poojamaurya22/uo/docs/walle_head_tilt.png

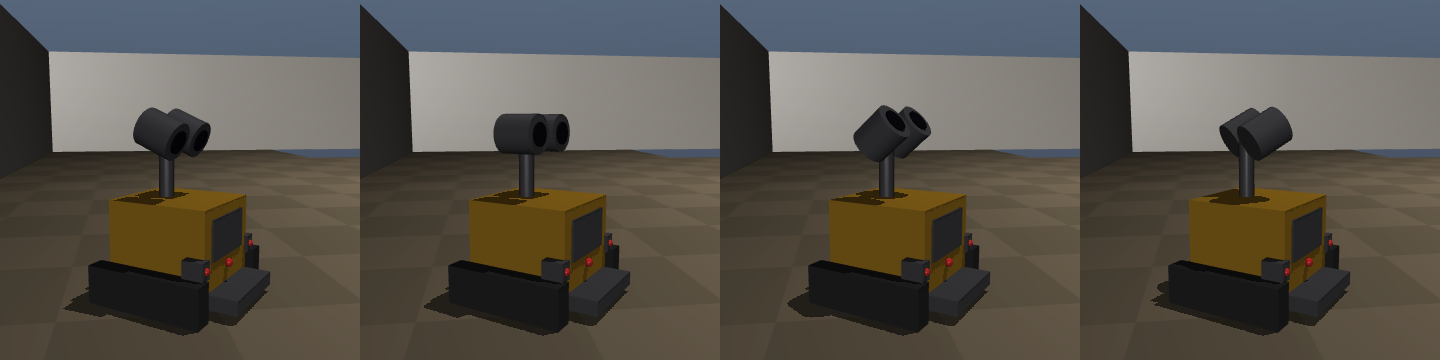
docs/walle_head_tilt.png
