poojamaurya22/uo/docs/walle_photo.png

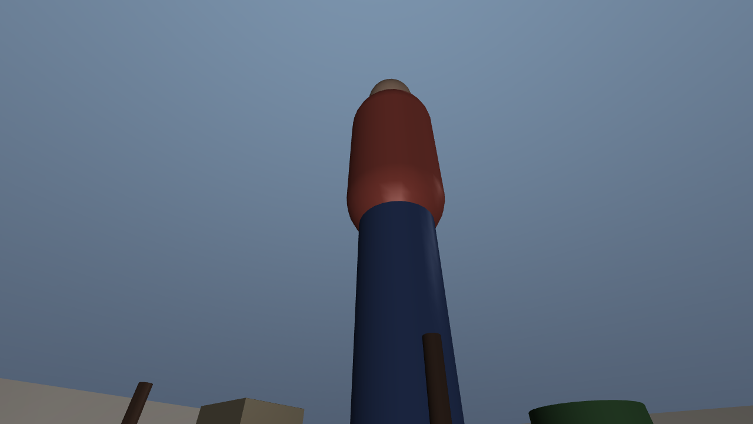
docs/walle_photo.png
