poojamaurya22/uo/hardware/preview/belt.png

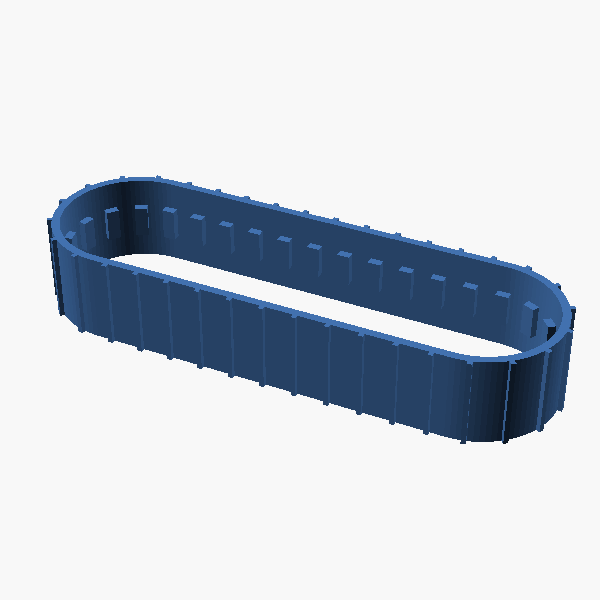
hardware/preview/belt.png
