poojamaurya22/uo/hardware/preview/body.png

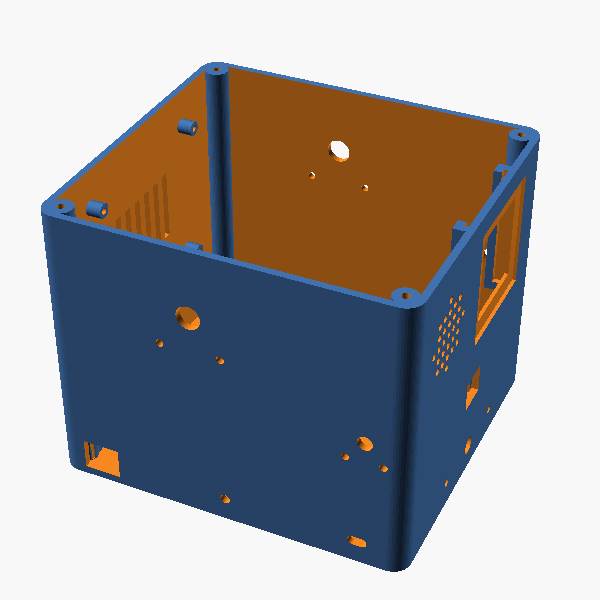
hardware/preview/body.png
