poojamaurya22/uo/hardware/preview/chest_bezel.png

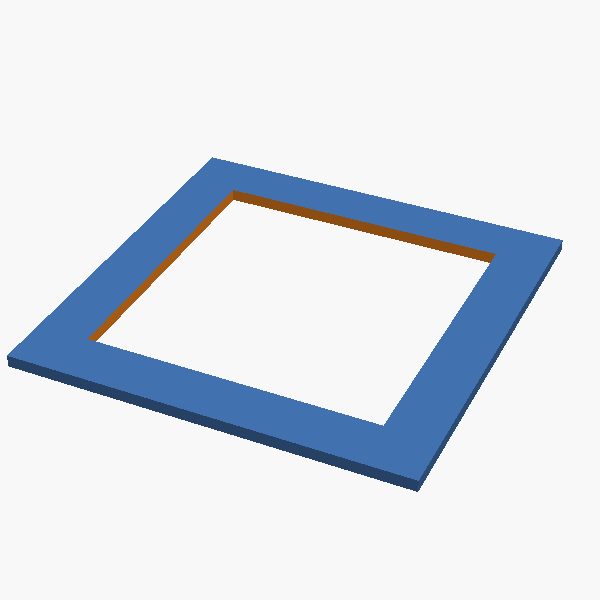
hardware/preview/chest_bezel.png
