poojamaurya22/uo/hardware/preview/chest_cover.png

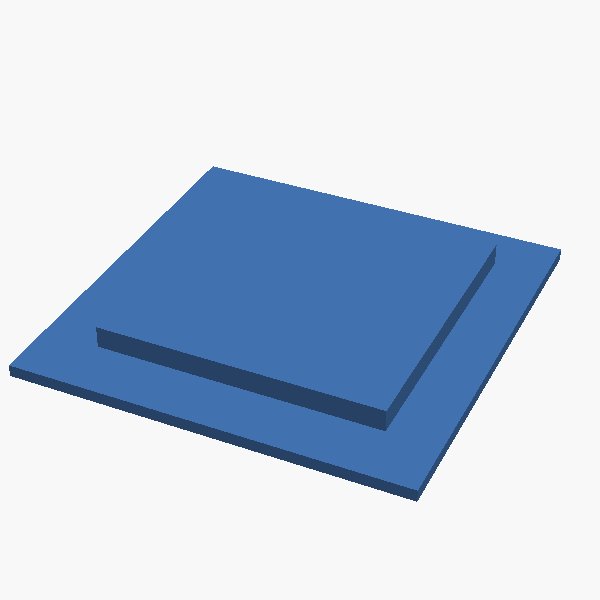
hardware/preview/chest_cover.png
