poojamaurya22/uo/hardware/preview/dock.png

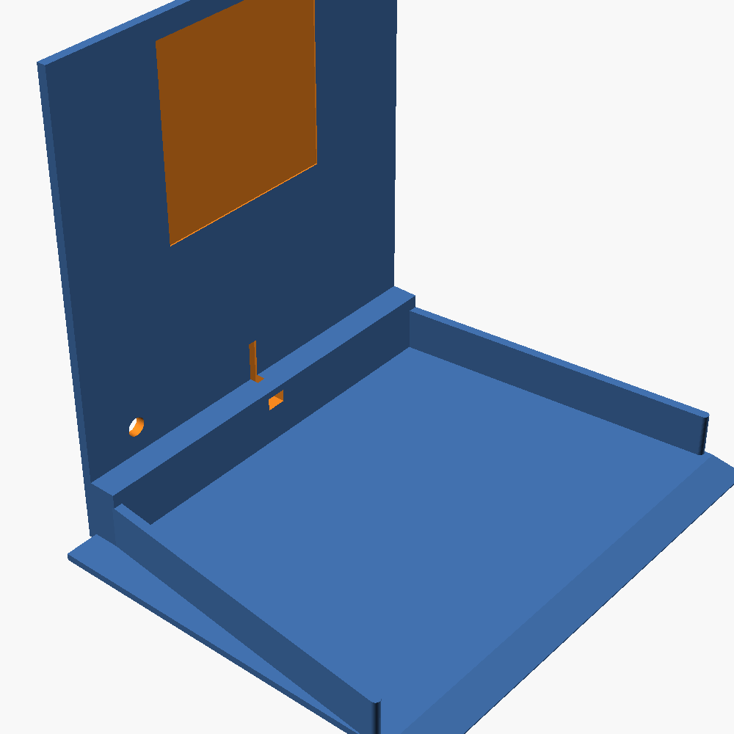
hardware/preview/dock.png
