poojamaurya22/uo/hardware/preview/dock_base.png

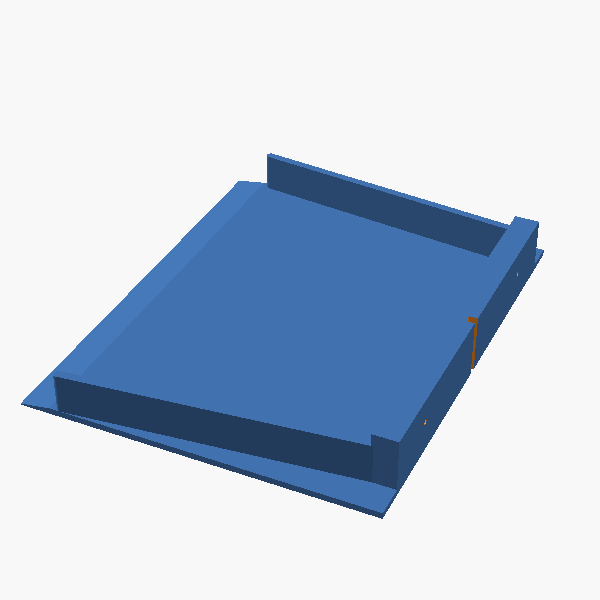
hardware/preview/dock_base.png
