poojamaurya22/uo/hardware/preview/dock_wall.png

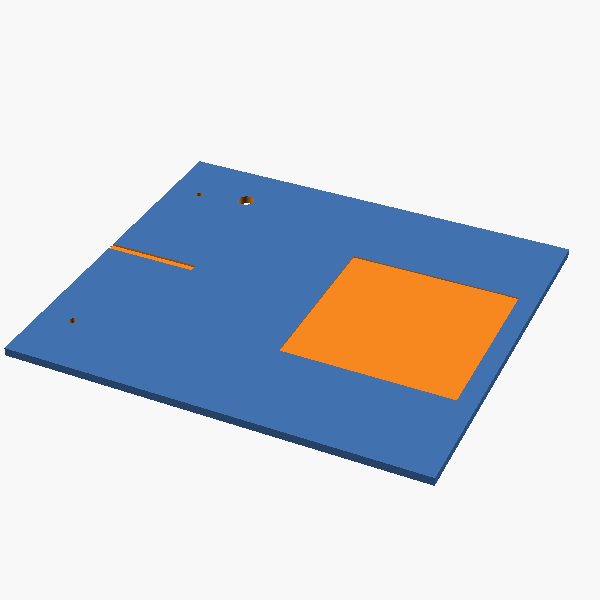
hardware/preview/dock_wall.png
