poojamaurya22/uo/hardware/preview/eye_camera.png

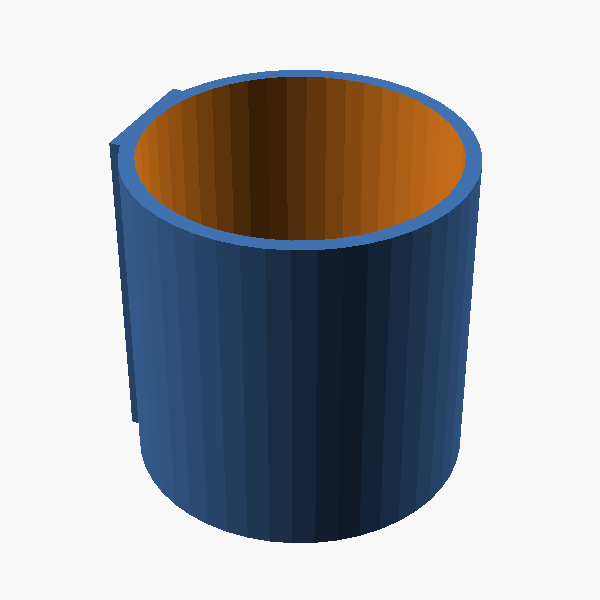
hardware/preview/eye_camera.png
