poojamaurya22/uo/hardware/preview/eye_cap.png

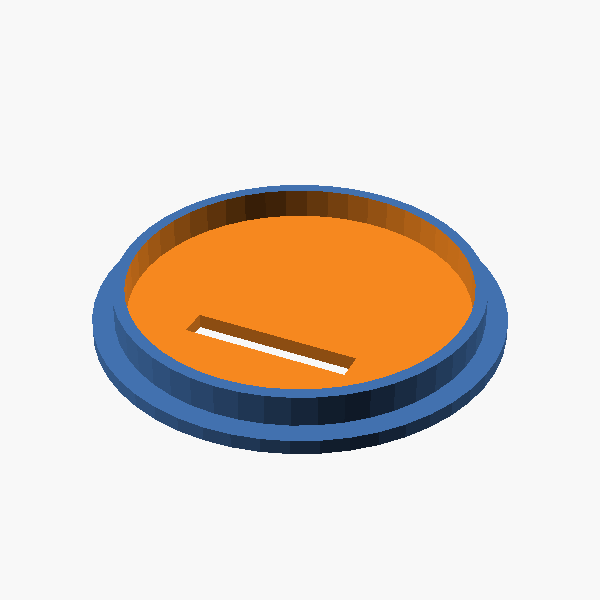
hardware/preview/eye_cap.png
