poojamaurya22/uo/hardware/preview/eye_plate.png

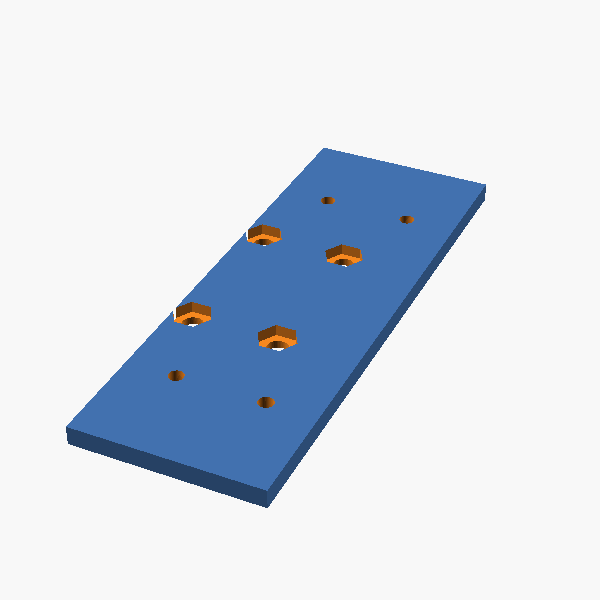
hardware/preview/eye_plate.png
