poojamaurya22/uo/hardware/preview/hand_left.png

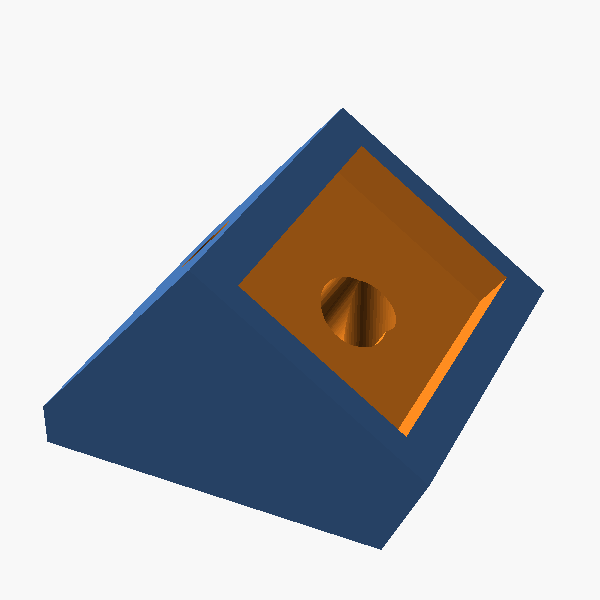
hardware/preview/hand_left.png
