poojamaurya22/uo/hardware/preview/head_yoke.png

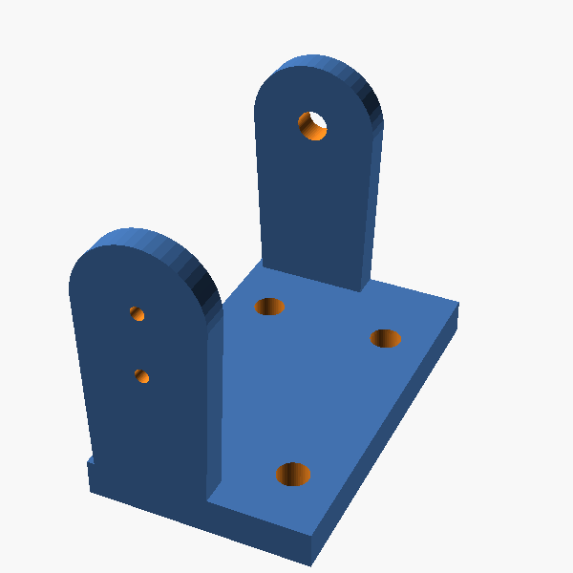
hardware/preview/head_yoke.png
