poojamaurya22/uo/hardware/preview/lip_rear.png

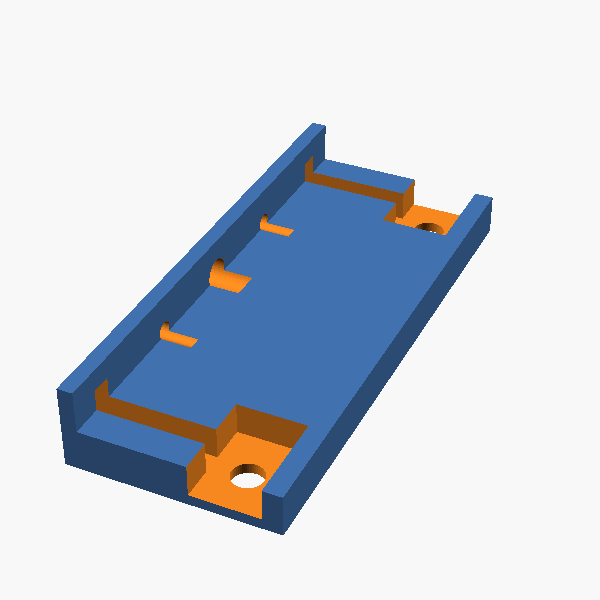
hardware/preview/lip_rear.png
