poojamaurya22/uo/hardware/preview/motor_strap.png

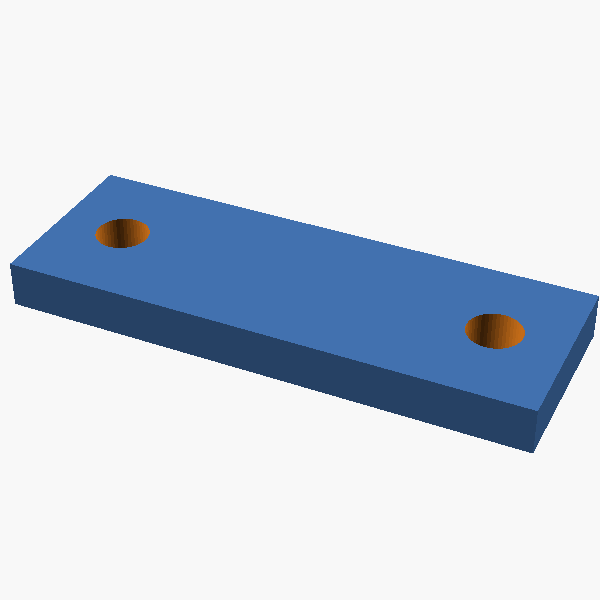
hardware/preview/motor_strap.png
