poojamaurya22/uo/hardware/preview/neck.png

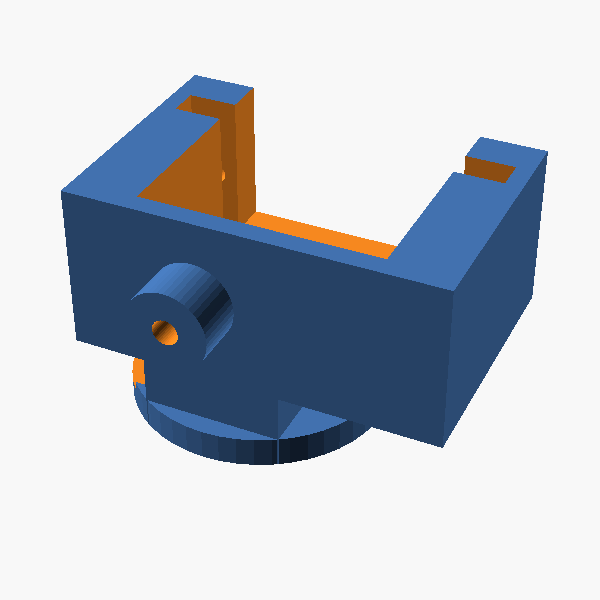
hardware/preview/neck.png
