poojamaurya22/uo/hardware/preview/neck_mount.png

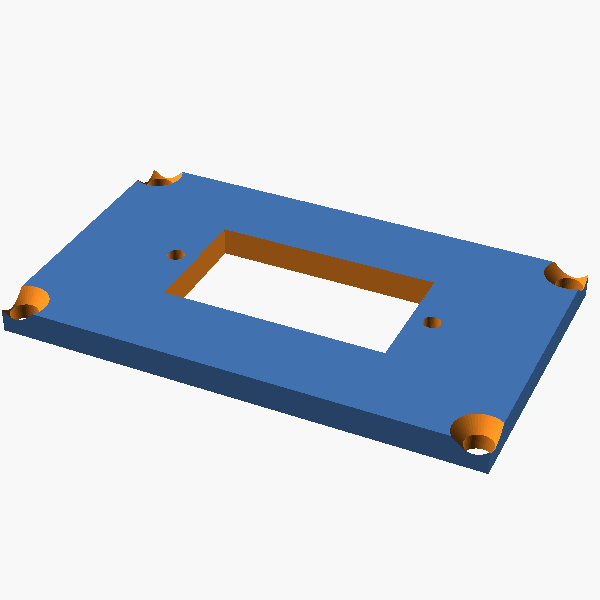
hardware/preview/neck_mount.png
