poojamaurya22/uo/hardware/preview/road_wheel.png

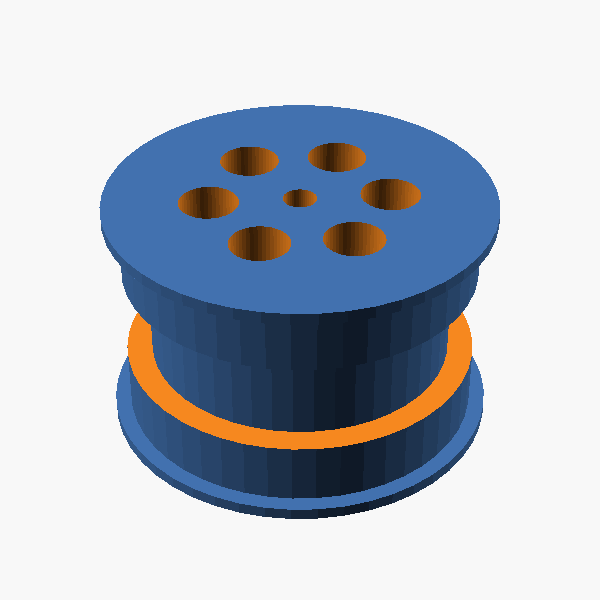
hardware/preview/road_wheel.png
