poojamaurya22/uo/hardware/preview/spacer.png

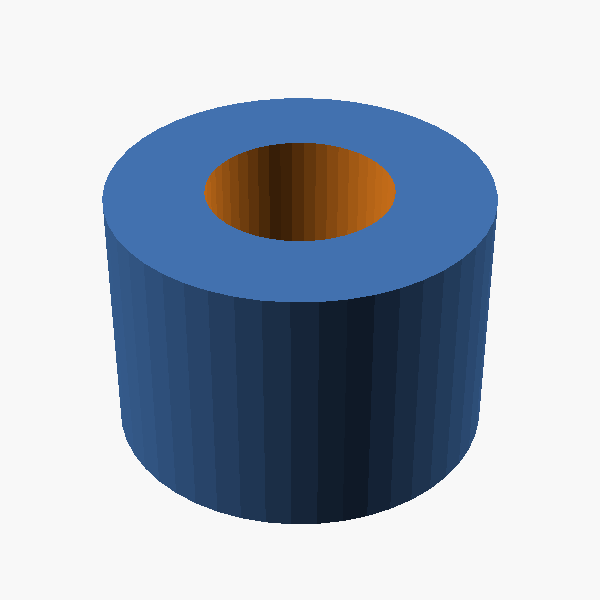
hardware/preview/spacer.png
