poojamaurya22/uo/hardware/stl/lip_rear.stl

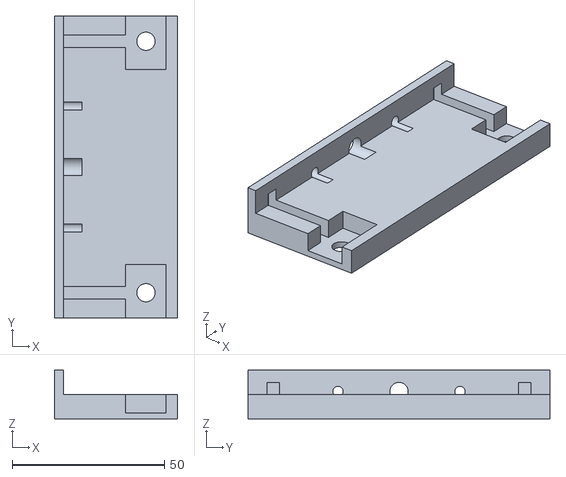
[picture p26: CAD file, 2026-10-28]
hardware/stl/lip_rear.stl
40.4 x 99.0 x 16.0
