poojamaurya22/uo/hardware/stl/head_yoke.stl

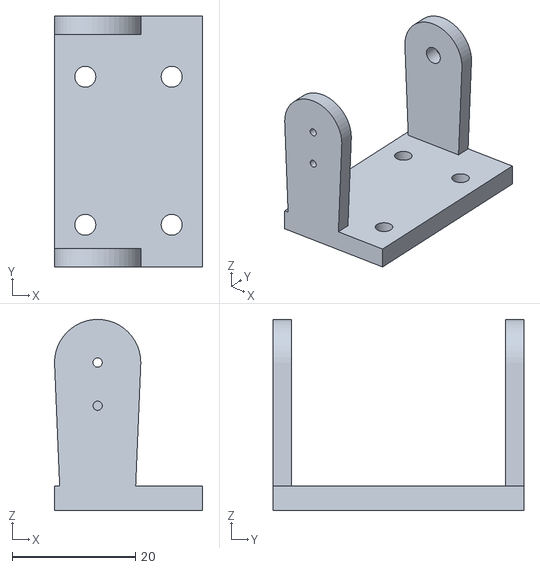
[picture p27: CAD file, 2026-10-28]
hardware/stl/head_yoke.stl
24.0 x 40.7 x 31.0
