poojamaurya22/uo/hardware/stl/sprocket_drive.stl

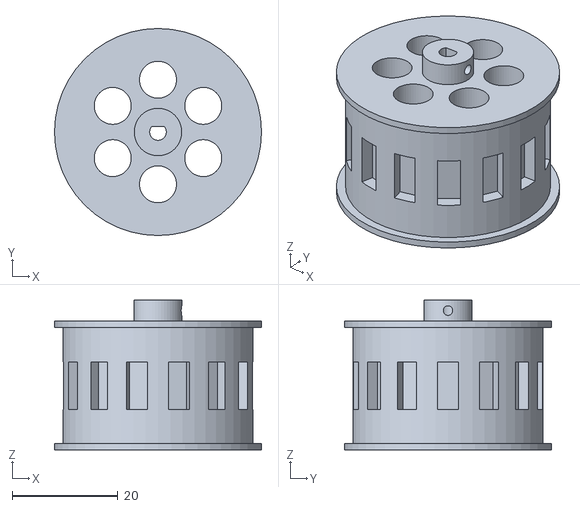
[picture p28: CAD file, 2026-10-28]
hardware/stl/sprocket_drive.stl
39.2 x 39.2 x 28.4
