poojamaurya22/uo/hardware/stl/neck.stl

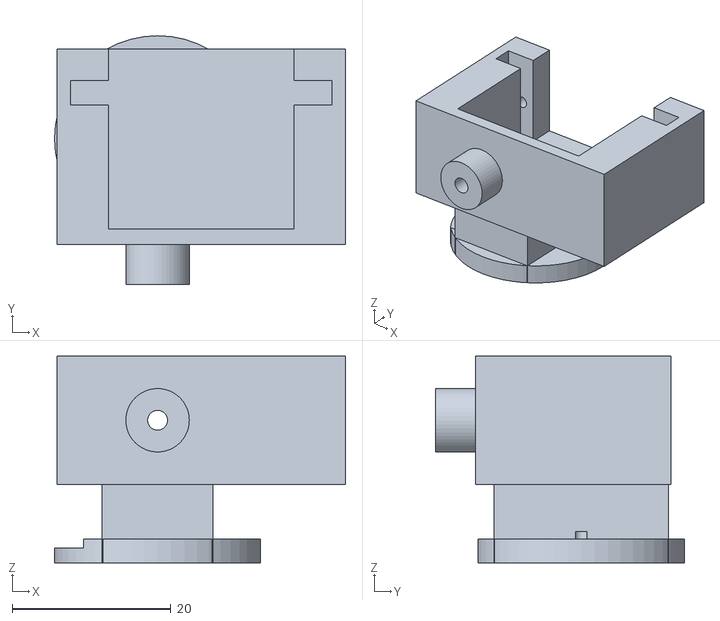
[picture p29: CAD file, 2026-10-28]
hardware/stl/neck.stl
36.7 x 31.4 x 26.1
