poojamaurya22/uo/hardware/stl/neck_mount.stl

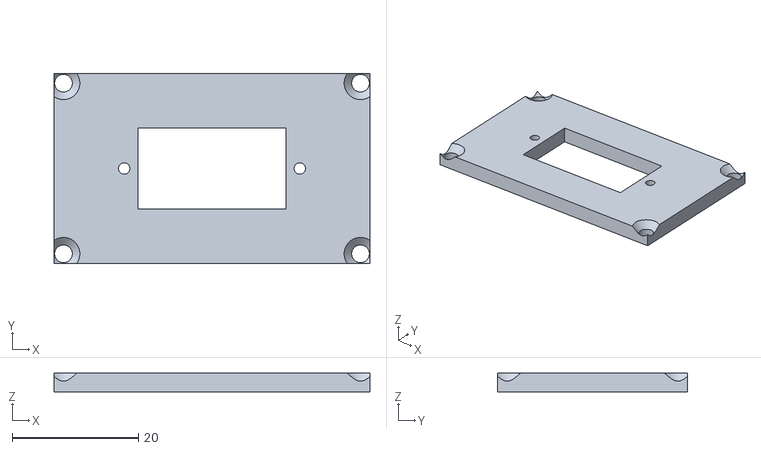
[picture p30: CAD file, 2026-10-28]
hardware/stl/neck_mount.stl
50.0 x 30.0 x 3.00
