poojamaurya22/uo/hardware/stl/dock_base.stl

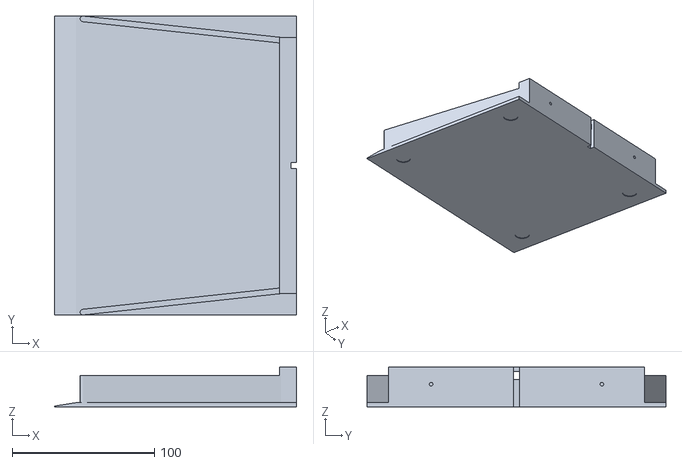
[picture p31: CAD file, 2026-10-28]
hardware/stl/dock_base.stl
170.0 x 210.0 x 28.0
