poojamaurya22/uo/hardware/stl/road_wheel.stl

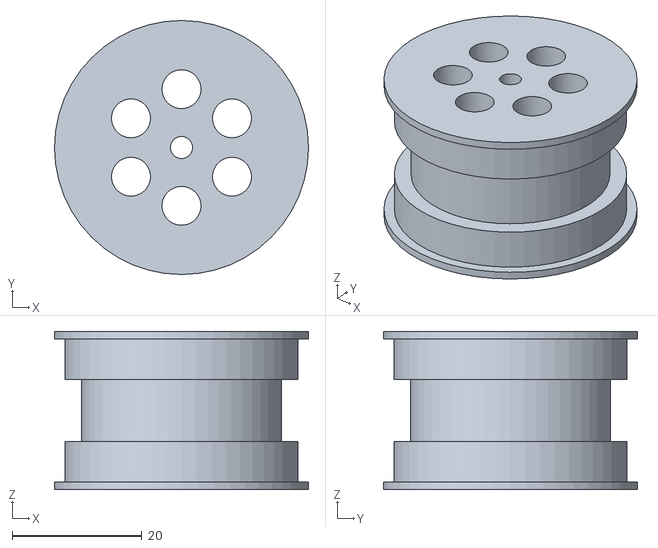
[picture p32: CAD file, 2026-10-28]
hardware/stl/road_wheel.stl
39.2 x 39.2 x 24.4
