poojamaurya22/uo/hardware/stl/lid.stl

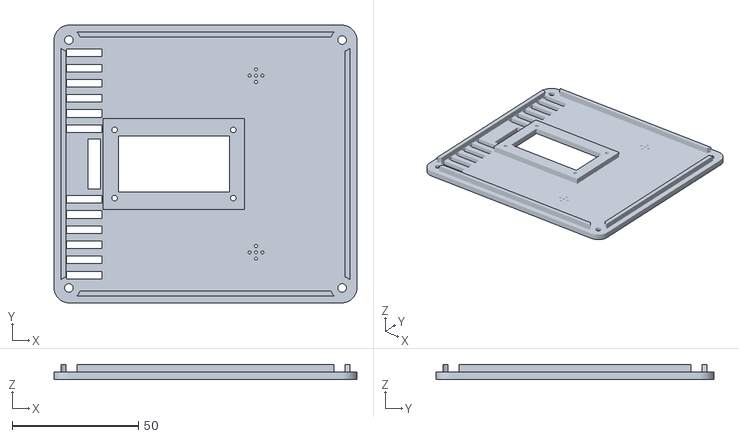
[picture p33: CAD file, 2026-10-28]
hardware/stl/lid.stl
120.0 x 110.0 x 6.00
