poojamaurya22/uo/hardware/stl/hand_right.stl

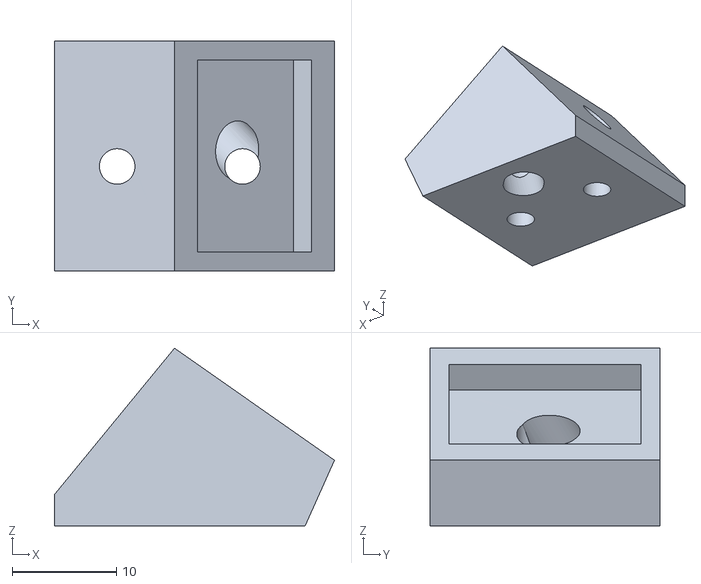
[picture p34: CAD file, 2026-10-28]
hardware/stl/hand_right.stl
26.8 x 22.0 x 17.0
