poojamaurya22/uo/hardware/stl/eye_led.stl

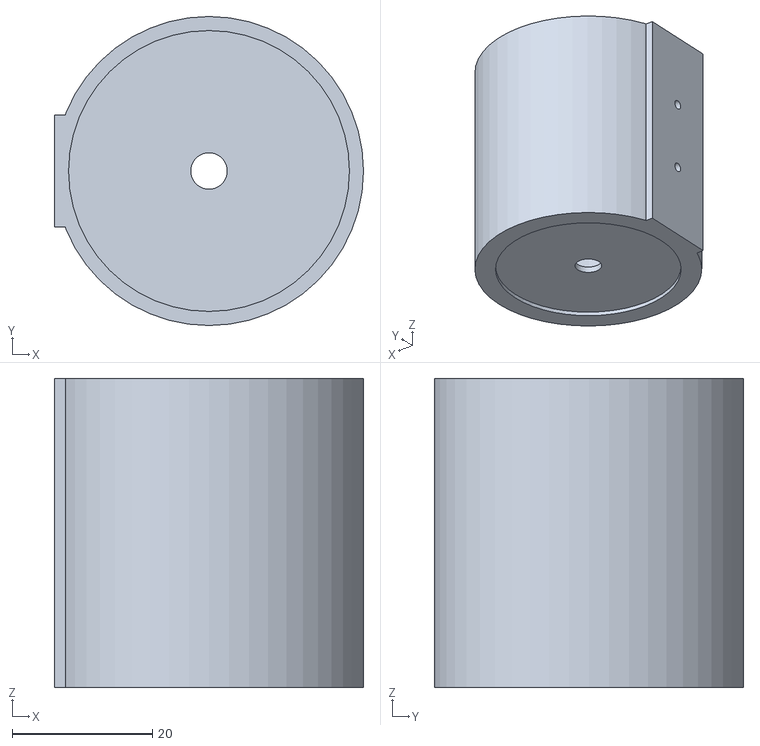
[picture p35: CAD file, 2026-10-28]
hardware/stl/eye_led.stl
44.0 x 44.0 x 44.0
