poojamaurya22/uo/hardware/stl/scoop_front.stl

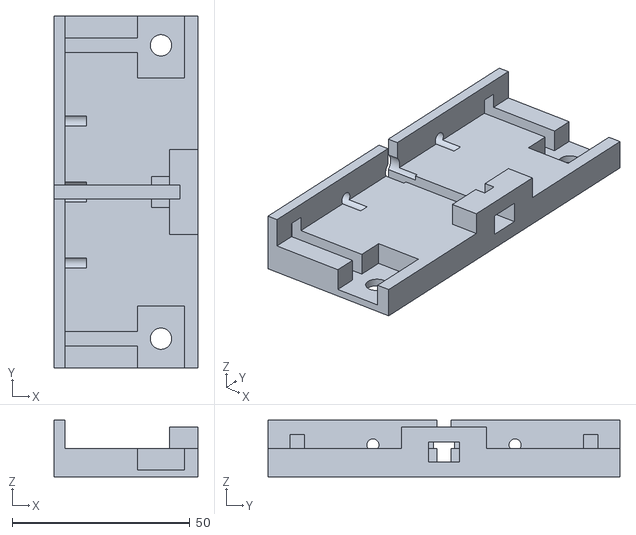
[picture p36: CAD file, 2026-10-28]
hardware/stl/scoop_front.stl
40.4 x 99.0 x 16.0
