poojamaurya22/uo/hardware/stl/sprocket_idler.stl

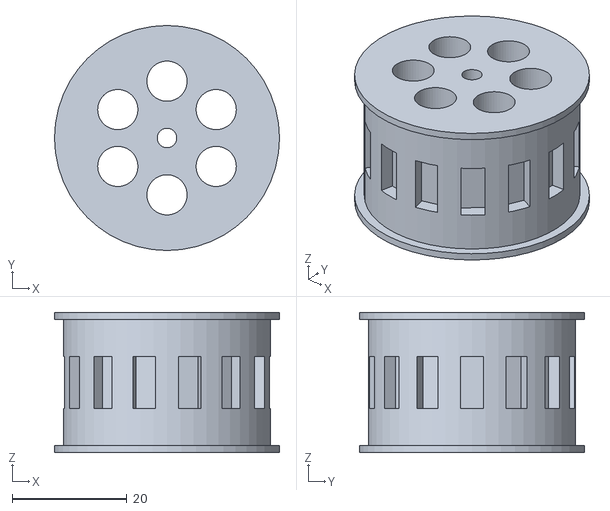
[picture p37: CAD file, 2026-10-28]
hardware/stl/sprocket_idler.stl
39.2 x 39.2 x 24.4
