poojamaurya22/uo/hardware/stl/dock_wall.stl

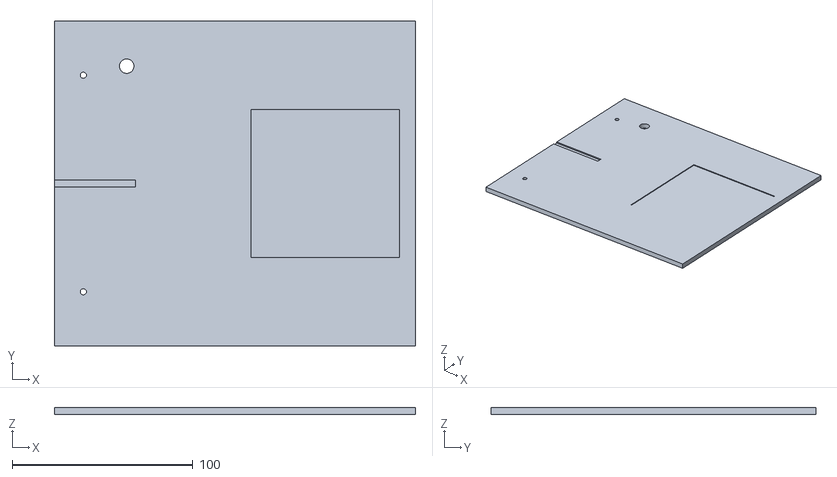
[picture p38: CAD file, 2026-10-28]
hardware/stl/dock_wall.stl
200.0 x 180.0 x 4.00
