poojamaurya22/uo/hardware/stl/eye_cap.stl

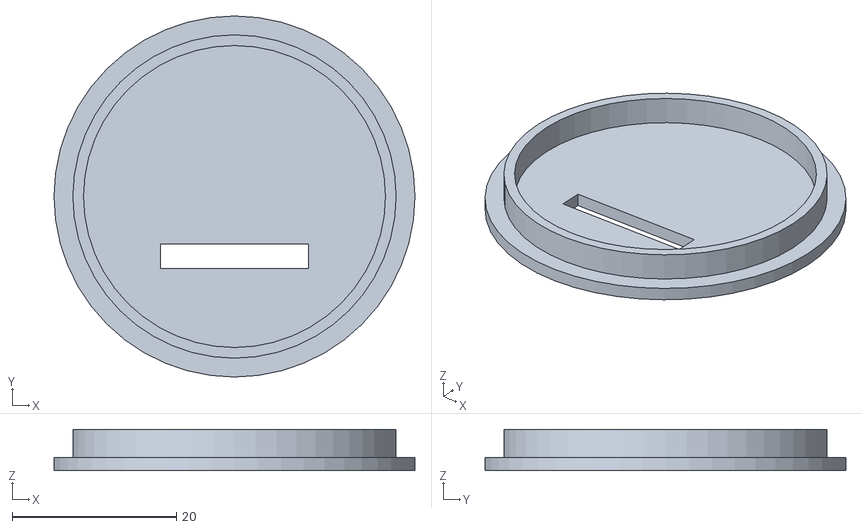
[picture p39: CAD file, 2026-10-28]
hardware/stl/eye_cap.stl
44.0 x 44.0 x 5.00
