poojamaurya22/uo/hardware/stl/eye_plate.stl

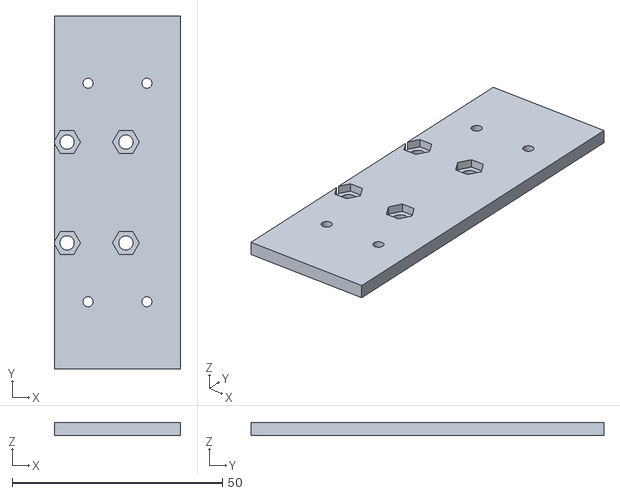
[picture p40: CAD file, 2026-10-28]
hardware/stl/eye_plate.stl
30.0 x 84.0 x 3.00
