poojamaurya22/uo/hardware/stl/body.stl

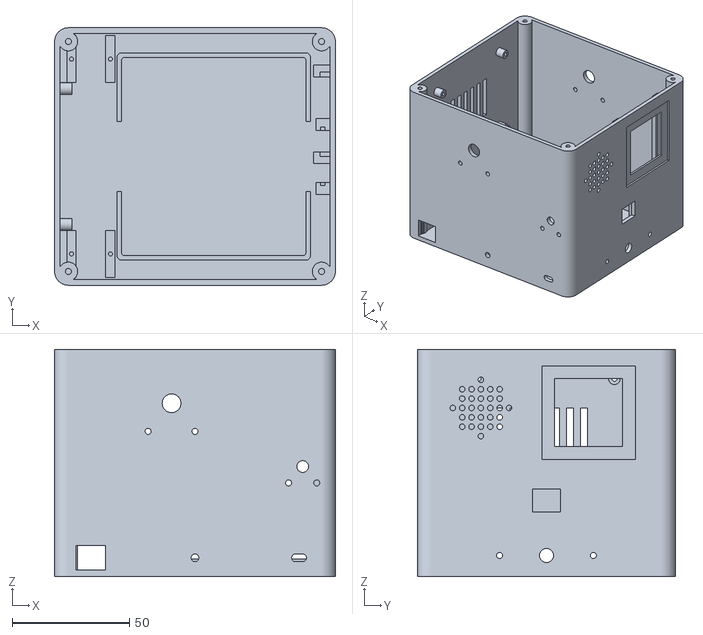
[picture p41: CAD file, 2026-10-28]
hardware/stl/body.stl
120.0 x 110.0 x 97.0
