poojamaurya22/uo/hardware/stl/motor_strap.stl

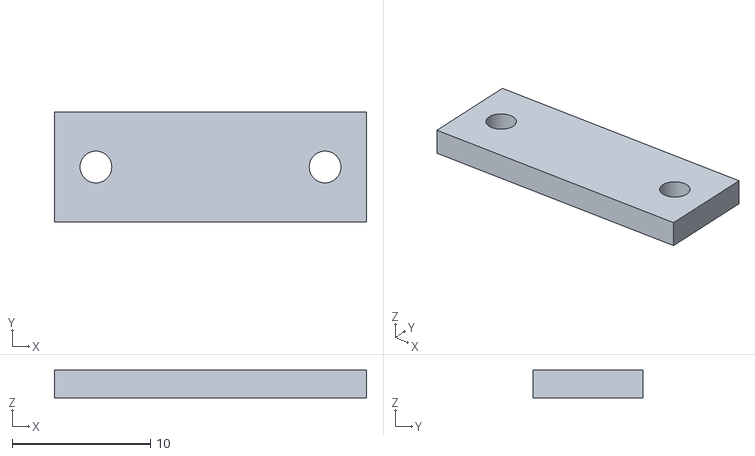
[picture p42: CAD file, 2026-10-28]
hardware/stl/motor_strap.stl
22.6 x 8.00 x 2.00
