poojamaurya22/uo/hardware/stl/chest_bezel.stl

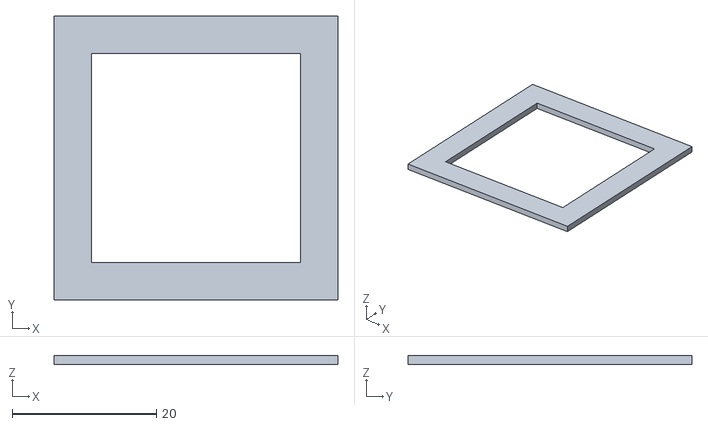
[picture p43: CAD file, 2026-10-28]
hardware/stl/chest_bezel.stl
39.4 x 39.4 x 1.20
