poojamaurya22/uo/hardware/stl/chest_cover.stl

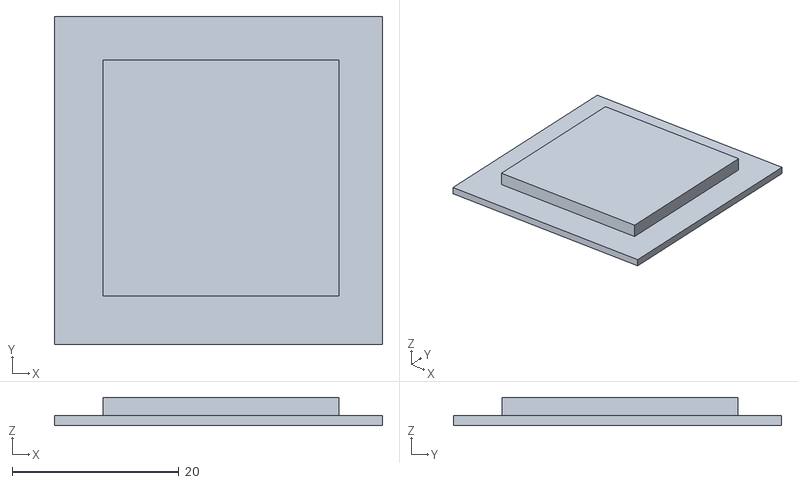
[picture p44: CAD file, 2026-10-28]
hardware/stl/chest_cover.stl
39.4 x 39.4 x 3.40
