poojamaurya22/uo/hardware/stl/belt.stl

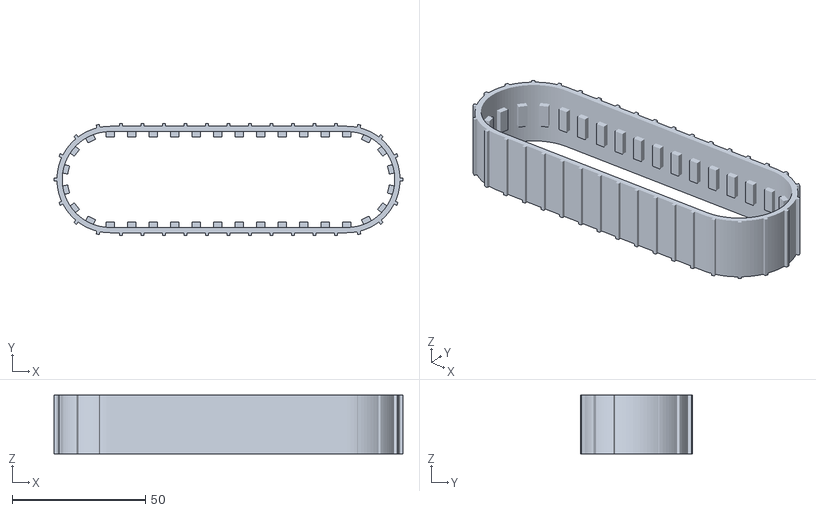
[picture p45: CAD file, 2026-10-28]
hardware/stl/belt.stl
131.1 x 42.2 x 22.0
