poojamaurya22/uo/hardware/stl/spacer.stl

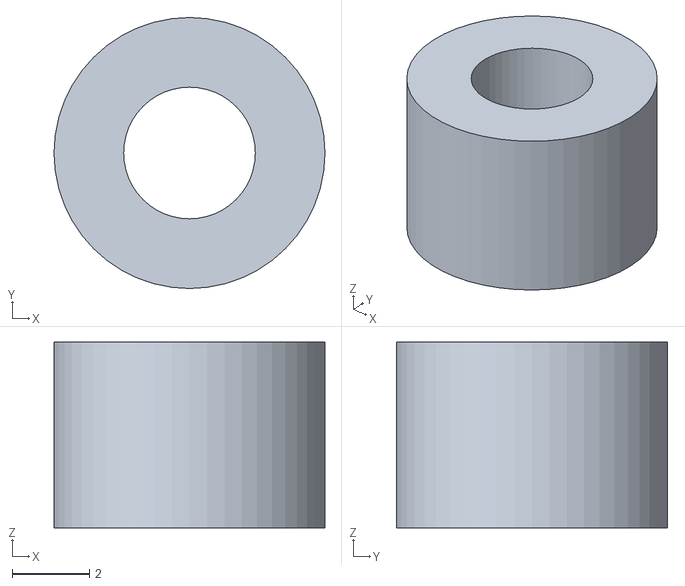
[picture p46: CAD file, 2026-10-28]
hardware/stl/spacer.stl
7.00 x 7.00 x 4.80
