poojamaurya22/uo/hardware/params.scad

// Generated by scripts/gen_scad_params.py from petsim.robot.RobotSpec. Do not edit.
// All values in millimetres / degrees.
body_l = 120.0;
body_w = 110.0;
body_h = 100.0;
clearance = 12.0;
wheel_r = 20.0;
wheel_spacing_nominal = 45.0;
track_w = 22.0;
track_gap = 6.0;
neck_x = -18.0;
eye_r = 22.0;
eye_len = 44.0;
eye_y = 26.0;
eye_x = 10.0;
eye_centre_above_lid = 80.0;
tof_z = 32.5;
side_tof_yaw = 55.0;
side_tof_z = 40.0;
cliff_reach = 30.0;
