poojamaurya22/uo/(list of files, cad)

Other CAD files:
hardware/stl/eye_camera.stl
hardware/stl/hand_left.stl
