poojamaurya22/uo/hardware/preview/assembly_back.png

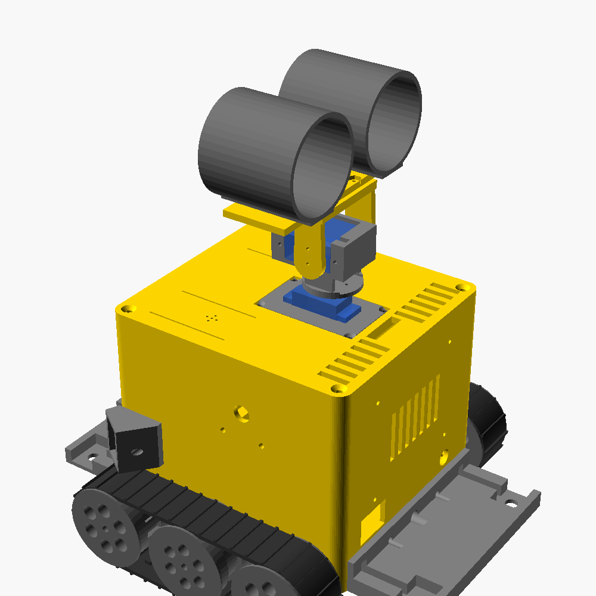
hardware/preview/assembly_back.png
