poojamaurya22/uo/(commit log)

2026-10-28 Add PetSim: MuJoCo simulation for training a follow-me companion robot
    Gymnasium environment modelling the planned robot (differential drive,
    8x8 ToF, cliff sensors, IMU, encoders, camera person detector) in a room
    with furniture and a stairwell, plus a hand-written baseline controller,
    PPO training, evaluation/video/photo tooling, a live viewer and tests.
    Claude-Session: https://claude.ai/code/session_01Y1YVJcb6xGMtmEHnUyri19
2026-10-28 Reshape the simulated robot into a Wall-E
    Box body on two tracks (3 coupled road wheels per side), binocular head
    on a pan/tilt neck with the camera in the left eye, chest 8x8 ToF, a
    side ToF in each hand, and cliff sensors on the front scoop. The neck
    tracks the person as a reflex; the policy drives the tracks and observes
    the neck angle. Observation fields are now addressed by name via OBS.
    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
2026-10-28 Add rear cliff sensors
    The first Wall-E policy backed away from the person at full speed into
    the stairwell: all cliff sensors were at the front, so it was blind in
    reverse. Two rear sensors on a rear lip close the gap; the baseline
    drives forward when they fire.
    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
2026-10-28 Add cliff and tilt safety reflexes between controller and motors
    Even with rear cliff sensors the trained policy occasionally reversed
    into the stairwell, and the tracks could climb a low box and tip over.
    A firmware-style filter now overrides the controller on cliff readings
    and on body tilt, estimated with a gyro/accelerometer complementary
    filter so driving jolts don't trigger it.
    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
2026-10-28 Evaluate with a single torch thread
    Parallel evaluations each grabbed several threads and slowed to a crawl;
    the policy network is tiny, so one thread is about 3x faster.
    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
2026-10-28 Save the trained Wall-E brain, run it without PyTorch, add follow video
    - models/walle_follow.npz: the trained follow policy exported to NumPy
    weights (330 KB); petsim/policy.py runs it with NumPy only, matching
    the PyTorch output to within 5e-7. scripts/export_policy.py exports.
    - Cliff sensors now sit ~2.5 cm beyond the track ends on a longer scoop
    and rear lip, and the cliff reflex takes priority over the tilt
    reflex: in a traced fall the rear sensor fired with the track already
    over the edge, and the tilt reflex then stopped the motors.
    - Chase camera and a side-by-side follow video/GIF in the README.
    Claude-Session: http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
2026-10-28 Use the best-scoring Wall-E brain and re-record the video
    On the final sensor layout over 200 runs: 87% of the time at 0.6-1.4 m
    (hand-written: 70%), 1% too close (6%), 0 falls for every controller.
    README gains a results table.
    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
2026-10-28 Add printable Wall-E hardware: parts, shopping list, assembly guide
    hardware/walle.scad models every printed part (body, lid, TPU track
    belts, drive/idler sprockets, road wheels, scoop and rear lip with cliff
    sensor pockets, angled side-ToF hands, neck with pan/tilt servo mounts,
    head yoke, camera and LED eyes). Sizes come from RobotSpec through the
    generated hardware/params.scad; a test keeps them in sync, and
    scripts/build_hardware.py exports the STLs and previews. All parts
    export as valid manifolds, fit a 220 mm bed and print without supports.
    RobotSpec.neck_height grows 60 -> 66.8 mm so the tilt servo fits; the
    trained brain still scores 87% at following distance with 0 falls.
    Co-Auth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
    [belt.stl, body.stl, eye_camera.stl, eye_cap.stl, eye_led.stl, hand_left.stl, hand_right.stl, head.stl]
2026-10-28 Use 4 cliff sensors instead of 5
    A stress test (random driving right at the stairwell edge, ~800 runs)
    gave 0 falls with both 5 sensors and 4 (one near each corner), 2% with
    3 and 16% with front-only, so the front-centre sensor is dropped from
    the simulation, safety reflex, baseline, printed scoop and parts list.
    The observation shrinks by one, so models/walle_follow.npz no longer
    matches; a retrained brain follows. NumpyPolicy now explains a size
    mismatch instead of failing on a matrix shape.
    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
    [lip_rear.stl, scoop_front.stl, walle.scad]
2026-10-28 Pi 5, 2S2P battery and self-charging dock; shopping list for India
    - Body: Raspberry Pi 5 standoffs on the back wall with intake vents
    behind it and lid vents above, a fenced bay for two 2x18650 holders,
    a power switch and a DC charging socket on the back wall.
    - Front scoop gains a forward-facing slot for the spring-pin half of a
    magnetic pogo connector; the rear lip is unchanged.
    - New dock_base (ramp, funnel arms, contact block with the pogo socket)
    and dock_wall (ArUco marker recess, DC jack).
    - RobotSpec.body_mass 0.55 -> 0.70 kg for the Pi 5 and extra cells.
    - hardware/README.md: shopping list rewritten for Indian stores in
    rupees, power wiring overview, dock assembly steps.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
    [body.stl, dock_base.stl, dock_wall.stl, eye_camera.stl, eye_cap.stl, eye_led.stl, hand_left.stl, head.stl]
2026-10-28 Chest window ready for an optional screen
    A 29 x 29 mm window with a recess on the chest, slotted rails behind it
    for a 1.54-inch ST7789 module, and two small parts: chest_cover to
    blank it now and chest_bezel to frame the screen later. The speaker
    grille moves to the right of the chest to make room.
    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
    [belt.stl, body.stl, chest_bezel.stl, chest_cover.stl, dock_base.stl, dock_wall.stl, eye_camera.stl, eye_cap.stl]
2026-10-28 Modular interfaces for later upgrades
    - Lid: standard opening with a ledge; the pan servo now sits in a
    separate neck_mount plate, so a stronger servo or an extending neck
    only needs a new plate. Wider cable slot behind the neck.
    - Head split into head_yoke and eye_plate, bolted with a 4 x M3
    pattern, leaving room for a head-roll module in between.
    - 2 x M3 + wire hole accessory mounts on both body sides for arms.
    - README: modular upgrades table and the parts/steps that changed.
    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
    [belt.stl, body.stl, dock_base.stl, dock_wall.stl, eye_camera.stl, eye_cap.stl, eye_led.stl, eye_plate.stl]
